LJKuhn/dsp-arduino-serialplotter/DSP/USART_Explicacion_Detallada.md

# USART - Explicación Detallada del Módulo de Comunicación Serial

## Tabla de Contenidos
1. [Introducción a USART](#introducción-a-usart)
2. [Arquitectura de Buffers Circulares](#arquitectura-de-buffers-circulares)
3. [Configuración de Registros AVR](#configuración-de-registros-avr)
4. [Sistema de Interrupciones](#sistema-de-interrupciones)
5. [Funciones de Escritura](#funciones-de-escritura)
6. [Funciones de Lectura](#funciones-de-lectura)
7. [Optimizaciones Implementadas](#optimizaciones-implementadas)
8. [Ejemplos de Uso](#ejemplos-de-uso)

---

## Introducción a USART

### ¿Qué es USART?

**USART** (Universal Synchronous/Asynchronous Receiver/Transmitter) es el módulo de hardware del microcontrolador ATmega2560 que maneja la comunicación serial. Es el componente que permite al Arduino comunicarse con la PC a través del cable USB.

### Características del módulo usart.h

Este módulo implementa comunicación serial **no bloqueante** con las siguientes características:

| Característica | Especificación |
|---|---|
| **Baudrate** | 38400 bps (configurable) |
| **Formato** | 8N1 (8 bits datos, sin paridad, 1 bit stop) |
| **Modo** | Asíncrono con doble velocidad (U2X=1) |
| **Buffers TX** | 256 bytes (circular) |
| **Buffers RX** | 64 bytes (circular) |
| **Interrupciones** | RX Complete, TX Data Register Empty |

### ¿Por qué es "no bloqueante"?

```cpp
// BLOQUEANTE (mal - bloquea CPU):
void escribir_malo(uint8_t byte) {
    while (!(UCSR0A & (1 << UDRE0)));  // ¡ESPERA ACTIVA! CPU bloqueada
    UDR0 = byte;
}

// NO BLOQUEANTE (bien - usa interrupciones):
bool escribir(uint8_t byte) {
    if (libre_escritura() > 0) {
        buffer_escritura[fin_e] = byte;  // Guarda en buffer
        fin_e++;                          // ISR lo enviará en segundo plano
        return true;
    }
    return false;  // Buffer lleno, pero CPU sigue funcionando
}
```

---

## Arquitectura de Buffers Circulares

### Concepto de Buffer Circular

Un buffer circular (o ring buffer) es una estructura de datos que funciona como una cola FIFO (First In, First Out) que reutiliza la misma memoria de forma continua.

```
Buffer de 256 bytes (índices 0-255):
┌─────┬─────┬─────┬─────┬─────┬─────┬─────┬─────┬─────┬─────┐
│  D  │  A  │  T  │  O  │     │     │     │     │  H  │  E  │
└─────┴─────┴─────┴─────┴─────┴─────┴─────┴─────┴─────┴─────┘
   ↑                                                       ↑
inicio_e (lee/consume)                                 fin_e (escribe/produce)
   │                                                       │
   └──────────────── Datos pendientes ────────────────────┘
```

### Operación de Wrap-Around

Cuando el índice llega al final del buffer, "envuelve" al inicio:

```cpp
// Incremento con wrap-around usando módulo
fin_e = (fin_e + 1) % 256;  // Si fin_e=255, siguiente es 0

// Equivalente optimizado (cuando tamaño es potencia de 2):
fin_e = (fin_e + 1) & 0xFF;  // Más rápido con operación AND
```

### Declaración en usart.h

```cpp
class USART {
public:
    // Buffers circulares
    uint8_t buffer_escritura[256];  // Buffer TX: 256 bytes (optimizado para Mega)
    uint8_t buffer_lectura[64];     // Buffer RX: 64 bytes
    
    // Punteros volatile (modificados por ISR)
    volatile uint8_t inicio_e = 0;  // Puntero de lectura TX (consume)
    volatile uint8_t fin_e = 0;     // Puntero de escritura TX (produce)
    volatile uint8_t inicio_l = 0;  // Puntero de lectura RX (consume)
    volatile uint8_t fin_l = 0;     // Puntero de escritura RX (produce)
};
```

### ¿Por qué `volatile`?

La palabra clave `volatile` es **crítica** en este código:

```cpp
volatile uint8_t fin_e = 0;  // ← DEBE ser volatile
```

**Razón:**
- `fin_e` es modificado por la **ISR** (código de interrupción)
- `fin_e` es leído por el **código principal** (loop)
- Sin `volatile`, el compilador podría optimizar lecturas y nunca ver los cambios
- Con `volatile`, cada acceso va directo a la memoria RAM

**Ejemplo del problema sin volatile:**

```cpp
// Sin volatile - compilador optimiza
while (fin_e != inicio_e) {
    // El compilador puede guardar fin_e en registro
    // y nunca ver que la ISR lo modificó
}

// Con volatile - compilador lee cada vez
while (fin_e != inicio_e) {
    // Cada comparación lee fin_e desde RAM
    // Ve los cambios hechos por la ISR
}
```

### Estados del Buffer

```cpp
// 1. BUFFER VACÍO:
inicio_e == fin_e  // No hay datos pendientes
┌─────┬─────┬─────┬─────┬─────┐
│     │     │     │     │     │
└─────┴─────┴─────┴─────┴─────┘
   ↑
inicio_e = fin_e = 0

// 2. BUFFER CON DATOS:
fin_e > inicio_e  // Datos lineales
┌─────┬─────┬─────┬─────┬─────┐
│     │  A  │  B  │  C  │     │
└─────┴─────┴─────┴─────┴─────┘
        ↑           ↑
    inicio_e=1  fin_e=4

// 3. BUFFER CON WRAP-AROUND:
fin_e < inicio_e  // Datos envolventes
┌─────┬─────┬─────┬─────┬─────┐
│  D  │  E  │     │     │  A  │
└─────┴─────┴─────┴─────┴─────┘
   ↑                       ↑
fin_e=2              inicio_e=4

// 4. BUFFER LLENO:
(fin_e + 1) % tamaño == inicio_e
┌─────┬─────┬─────┬─────┬─────┐
│  B  │  C  │  D  │  E  │     │  ← Un espacio vacío para distinguir lleno/vacío
└─────┴─────┴─────┴─────┴─────┘
        ↑                 ↑
    inicio_e=1        fin_e=4
```

### Cálculo de Espacio Disponible

```cpp
uint8_t libre_escritura(){
    uint8_t pendiente;
    
    // Calcular datos pendientes según posición de punteros
    if (fin_e >= inicio_e)
        pendiente = fin_e - inicio_e;       // Caso normal
    else
        pendiente = sizeof(buffer_escritura) - inicio_e + fin_e;  // Wrap-around
    
    return sizeof(buffer_escritura) - pendiente - 1;  // -1 para evitar ambigüedad
}
```

**Ejemplo numérico:**

```
Buffer de 256 bytes:
inicio_e = 200, fin_e = 50

Datos pendientes = 256 - 200 + 50 = 106 bytes
Espacio libre = 256 - 106 - 1 = 149 bytes

┌─────────────────────────────────────────────────┐
│ [50 bytes datos] [149 vacío] [106 bytes datos] │
└─────────────────────────────────────────────────┘
  0              50           199              255
  ↑                            ↑
fin_e                      inicio_e
```

---

## Configuración de Registros AVR

### Función begin(uint32_t baud)

Esta función inicializa el hardware USART del ATmega2560:

```cpp
void begin(uint32_t baud) {
    // PASO 1: Calcular divisor de baudrate
    UBRR0 = 16e6 / (8 * baud) - 1;
    
    // PASO 2: Configurar UCSR0A (Control and Status Register A)
    UCSR0A = doble_velocidad;
    
    // PASO 3: Configurar UCSR0B (Control and Status Register B)
    UCSR0B = interrupcion_rx | interrupcion_registro_vacio | activar_tx | activar_rx;
    
    // PASO 4: Configurar UCSR0C (Control and Status Register C)
    UCSR0C = modo_asincrono | paridad_desactivada | parada_1bit | caracter_8bits;
}
```

### Registro UBRR0 - Baudrate

**Fórmula para calcular UBRR0:**

```cpp
// Con modo U2X=1 (doble velocidad):
UBRR0 = (F_CPU / (8 × BAUD)) - 1

// Para 38400 baud @ 16MHz:
UBRR0 = (16,000,000 / (8 × 38400)) - 1
UBRR0 = (16,000,000 / 307,200) - 1
UBRR0 = 52.08 - 1
UBRR0 = 51.08 ≈ 51
```

**Baudrate real con UBRR0=51:**

```
BAUD_real = 16,000,000 / (8 × (51 + 1))
BAUD_real = 16,000,000 / 416
BAUD_real = 38,461 baud

Error = (38,461 - 38,400) / 38,400 × 100%
Error = 0.16% (excelente, <2% es aceptable)
```

### Registro UCSR0A - Control y Estado

```cpp
UCSR0A = doble_velocidad;  // = 1 << U2X0
```

**Bits del registro UCSR0A:**

```
UCSR0A (USART Control and Status Register A):
┌───┬───┬───┬───┬───┬───┬───┬───┐
│RXC│TXC│UDR│ FE│DOR│ PE│U2X│MPM│
└───┴───┴───┴───┴───┴───┴───┴───┘
 Bit: 7   6   5   4   3   2   1   0

Bit 1 (U2X0): Doble velocidad USART
  0 = Modo normal (divide por 16)
  1 = Doble velocidad (divide por 8) ← Mejor precisión
```

**¿Por qué doble velocidad?**

```
Modo normal (U2X=0):
UBRR0 = (16MHz / (16 × 38400)) - 1 = 25.04 ≈ 25
BAUD_real = 16MHz / (16 × 26) = 38,462 baud
Error = 0.16%

Doble velocidad (U2X=1):
UBRR0 = (16MHz / (8 × 38400)) - 1 = 51.08 ≈ 51
BAUD_real = 16MHz / (8 × 52) = 38,461 baud
Error = 0.16%

Ventaja: Mayor rango de valores UBRR0 → más opciones de baudrate
```

### Registro UCSR0B - Habilitación de Funciones

```cpp
UCSR0B = interrupcion_rx | interrupcion_registro_vacio | activar_tx | activar_rx;
```

**Bits del registro UCSR0B:**

```
UCSR0B (USART Control and Status Register B):
┌────┬────┬────┬────┬────┬────┬────┬────┐
│RXCI│TXCI│UDRI│RXEN│TXEN│UCSZ│ RXB│ TXB│
└────┴────┴────┴────┴────┴────┴────┴────┘
 Bit:  7    6    5    4    3    2    1    0

Bit 7 (RXCIE0): RX Complete Interrupt Enable
  1 = Genera ISR(USART0_RX_vect) cuando llega un byte

Bit 5 (UDRIE0): USART Data Register Empty Interrupt Enable
  1 = Genera ISR(USART0_UDRE_vect) cuando UDR0 está vacío

Bit 4 (RXEN0): Receiver Enable
  1 = Habilita la recepción de datos

Bit 3 (TXEN0): Transmitter Enable
  1 = Habilita la transmisión de datos
```

**Constantes definidas en usart.h:**

```cpp
const static uint8_t interrupcion_rx = 1 << RXCIE0;              // = 0b10000000
const static uint8_t interrupcion_registro_vacio = 1 << UDRIE0;  // = 0b00100000
const static uint8_t activar_tx = 1 << TXEN0;                    // = 0b00001000
const static uint8_t activar_rx = 1 << RXEN0;                    // = 0b00010000

// Resultado del OR:
UCSR0B = 0b10111000
         ↑↑ ↑↑↑
         ││ │││
         ││ ││└─ TXEN0: Transmisión habilitada
         ││ │└── RXEN0: Recepción habilitada
         ││ └─── (no usado)
         │└───── UDRIE0: ISR de registro vacío
         └────── RXCIE0: ISR de recepción completa
```

### Registro UCSR0C - Formato de Datos

```cpp
UCSR0C = modo_asincrono | paridad_desactivada | parada_1bit | caracter_8bits;
```

**Bits del registro UCSR0C:**

```
UCSR0C (USART Control and Status Register C):
┌────┬────┬────┬────┬────┬────┬────┬────┐
│UMSE│UPM1│UPM0│USBS│UCSZ│UCSZ│UCPOL│   │
└────┴────┴────┴────┴────┴────┴─────┴───┘
 Bit:  7    6    5    4    3    2    1    0

Bits 7-6 (UMSEL0): USART Mode Select
  00 = Modo asíncrono (UART)
  01 = Modo síncrono
  11 = Modo SPI maestro

Bits 5-4 (UPM0): Parity Mode
  00 = Sin paridad
  10 = Paridad par
  11 = Paridad impar

Bit 3 (USBS0): Stop Bit Select
  0 = 1 bit de parada
  1 = 2 bits de parada

Bits 2-1 (UCSZ0): Character Size
  011 = 8 bits de datos (junto con UCSZ2=0 en UCSR0B)
```

**Configuración 8N1:**

```
8N1 = 8 bits datos, No paridad, 1 bit stop
UCSR0C = 0b00000110
         ││││││││
         ││││││└└─ (no usado)
         ││││└└─── UCSZ0 = 11 (8 bits con UCSZ2=0)
         │││└───── USBS0 = 0 (1 stop bit)
         ││└└───── UPM0 = 00 (sin paridad)
         └└─────── UMSEL0 = 00 (asíncrono)
```

---

## Sistema de Interrupciones

El módulo USART usa **dos interrupciones** independientes para transmisión y recepción:

### 1. ISR de Recepción (RX)

**ISR(USART0_RX_vect)** se dispara automáticamente cuando:
- Un byte completo ha sido recibido
- El registro UDR0 contiene el dato
- El flag RXC0 (RX Complete) se pone en 1

```cpp
// En DSP.ino
ISR(USART0_RX_vect)
{
   uint8_t leido = UDR0;  // Leer byte recibido (limpia flag RXC0)
   
   if (usart.libre_lectura()){  // ¿Hay espacio en buffer?
      usart.buffer_lectura[usart.fin_l] = leido;  // Guardar en buffer circular
      usart.fin_l = (usart.fin_l + 1) % sizeof(usart.buffer_lectura);  // Avanzar puntero
   }
   // Si no hay espacio, el byte se descarta (overflow)
}
```

**Timing de la ISR:**

```
Tiempo 0μs:     PC envía byte 0xAB por USB
                ↓
t=10μs:         Hardware USART detecta start bit
                ↓
t=270μs:        Hardware USART recibe 8 bits + stop bit (@ 38400 baud)
                ↓ (Automático - 0 ciclos de CPU)
                Byte 0xAB → UDR0
                Flag RXC0 = 1
                ↓
t=271μs:        CPU detecta RXC0=1
                ISR(USART0_RX_vect) se dispara
                ↓
                Ejecución de ISR (~15 ciclos = 0.94 μs):
                - Leer UDR0 (4 ciclos)
                - Verificar espacio (3 ciclos)
                - Guardar en buffer (2 ciclos)
                - Incrementar puntero (3 ciclos)
                - Overhead ISR (3 ciclos)
                ↓
t=272μs:        ISR termina
                CPU vuelve al código principal
```

**Overhead de la ISR:**

```
Tiempo de ISR = 15 ciclos @ 16MHz = 0.94 μs
Frecuencia de llamada = 38400 bytes/s @ 38400 baud
Overhead total = 0.94 μs × 3840 Hz = 0.36% de CPU
```

### 2. ISR de Transmisión (TX)

**ISR(USART0_UDRE_vect)** se dispara cuando:
- El registro UDR0 está vacío (listo para recibir nuevo byte)
- El flag UDRE0 (Data Register Empty) = 1
- El bit UDRIE0 está habilitado

```cpp
// En DSP.ino
ISR(USART0_UDRE_vect)
{
   usart.udrie();  // Llamar método de la clase
}

// En usart.h
void udrie(){
    // Si no hay más datos pendientes
    if (!pendiente_escritura()){
        UCSR0B &= ~interrupcion_registro_vacio;  // Desactivar ISR
        return;
    }

    // Enviar siguiente byte del buffer circular
    UDR0 = buffer_escritura[inicio_e];
    inicio_e = (inicio_e + 1) % sizeof(buffer_escritura);
}
```

**Flujo completo de transmisión:**

```
TIEMPO t=0:     loop() llama usart.escribir(128)
                │
                ├─► Si UDR0 vacío: UDR0 = 128 (directo)
                │   Si UDR0 ocupado: buffer_escritura[fin_e] = 128
                │   fin_e++
                │   UCSR0B |= UDRIE0 (activar ISR)
                └─► return true (sin bloqueo)

TIEMPO t=10μs:  ISR(USART0_UDRE_vect) se dispara
                │
                ├─► Verificar: ¿hay datos en buffer?
                │   Sí → UDR0 = buffer_escritura[inicio_e]
                │        inicio_e++
                │   No → UCSR0B &= ~UDRIE0 (desactivar ISR)
                └─► return

TIEMPO t=270μs: Byte transmitido completamente
                Hardware pone UDRE0=1
                ISR se dispara nuevamente (si hay más datos)

... Ciclo se repite hasta vaciar buffer ...
```

**Auto-deshabilitación de ISR:**

```cpp
void udrie(){
    if (!pendiente_escritura()){
        UCSR0B &= ~interrupcion_registro_vacio;  // Apagar ISR
        return;
    }
    // ... enviar byte
}
```

**¿Por qué deshabilitar la ISR?**
- Si no hay datos, la ISR se llamaría constantemente (~38400 veces/segundo)
- Desperdiciaría CPU ejecutando código vacío
- Con auto-deshabilitación: ISR solo activa cuando hay trabajo real

---

## Funciones de Escritura

### 1. escribir() - Escritura No Bloqueante Principal

```cpp
bool escribir(uint8_t byte){
    // OPTIMIZACIÓN 1: Escritura directa si registro vacío
    if (!pendiente_escritura() && registro_vacio()){
        UDR0 = byte;  // Escribir directamente al hardware
        return true;   // Transmisión inicia inmediatamente
    }

    // OPTIMIZACIÓN 2: Verificar espacio en buffer
    if (libre_escritura() == 0)
        return false;  // Buffer saturado - llamador debe manejar

    // RUTA NORMAL: Agregar al buffer circular
    buffer_escritura[fin_e] = byte;
    fin_e = (fin_e + 1) % sizeof(buffer_escritura);
    
    // Activar interrupción UDRE para transmisión automática
    UCSR0B |= interrupcion_registro_vacio;
    return true;
}
```

**Diagrama de decisión:**

```
escribir(byte)
    │
    ├─ ¿Buffer vacío Y registro vacío?
    │   ├─ SÍ → UDR0 = byte (directo al hardware)
    │   │       return true
    │   │
    │   └─ NO → ¿Hay espacio en buffer?
    │           ├─ SÍ → buffer[fin_e] = byte
    │           │       fin_e++
    │           │       Activar UDRIE0
    │           │       return true
    │           │
    │           └─ NO → return false (buffer lleno)
```

**Ventajas del diseño:**

1. **Fast-path directo:** Si todo está vacío, escribe directamente sin overhead de buffer
2. **No bloqueante:** Nunca espera, devuelve false si lleno
3. **Auto-ISR:** Solo activa interrupciones cuando es necesario

### 2. escribir_espera() - Escritura Bloqueante

```cpp
void escribir_espera(uint8_t byte){
    while (!escribir(byte));  // Reintenta hasta que tenga éxito
}
```

**Uso:**
- Para debug o inicialización donde no importa bloquear
- Garantiza que el byte se envía (útil para mensajes críticos)
- **NO USAR en loop principal** - puede causar pérdida de muestras

### 3. escribir_bloque() - Transmisión en Ráfaga

```cpp
uint8_t escribir_bloque(const uint8_t* datos, uint8_t tamano) {
    uint8_t escritos = 0;
    
    // Primer byte directo si es posible
    if (!pendiente_escritura() && registro_vacio() && tamano > 0) {
        UDR0 = datos[0];
        escritos = 1;
        datos++;
        tamano--;
    }
    
    // Resto al buffer
    while (tamano > 0 && libre_escritura() > 0) {
        buffer_escritura[fin_e] = *datos;
        fin_e = (fin_e + 1) % sizeof(buffer_escritura);
        datos++;
        tamano--;
        escritos++;
    }
    
    // Activar ISR si hay datos pendientes
    if (pendiente_escritura()) {
        UCSR0B |= interrupcion_registro_vacio;
    }
    
    return escritos;  // Retorna cuántos bytes se pudieron escribir
}
```

**Ventaja:** Reduce overhead llamando a `escribir()` múltiples veces

---

## Funciones de Lectura

### 1. leer() - Lectura No Bloqueante

```cpp
uint8_t leer(){
    uint8_t valor = buffer_lectura[inicio_l];
    inicio_l = (inicio_l + 1) % sizeof(buffer_lectura);
    return valor;
}
```

**Importante:** Esta función **NO verifica** si hay datos disponibles. El usuario debe llamar primero a `pendiente_lectura()`:

```cpp
// USO CORRECTO:
if (usart.pendiente_lectura()) {
    uint8_t dato = usart.leer();  // Seguro
}

// USO INCORRECTO (podría leer basura):
uint8_t dato = usart.leer();  // ¿Hay datos? No se sabe
```

### 2. leer_espera() - Lectura Bloqueante

```cpp
uint8_t leer_espera(){
    while (!pendiente_lectura());  // Espera hasta que llegue un byte
    return leer();
}
```

**Uso:** Debug o inicialización donde se espera una respuesta específica

### 3. pendiente_lectura() - Verificación de Datos

```cpp
bool pendiente_lectura(){
    return fin_l != inicio_l;  // true si hay datos en buffer
}
```

**Uso típico en loop():**

```cpp
void loop() {
    if (beat) {
        // Enviar dato
        usart.escribir(muestra_adc);
        
        // Recibir si hay datos disponibles
        if (usart.pendiente_lectura()) {
            valor = usart.leer();
        }
    }
}
```

---

## Optimizaciones Implementadas

### 1. Buffers Aumentados para Mega 2560

```cpp
// ANTES (versión original para Arduino Uno con 2KB RAM):
uint8_t buffer_escritura[128], buffer_lectura[32];

// AHORA (optimizado para Mega 2560 con 8KB RAM):
uint8_t buffer_escritura[256], buffer_lectura[64];  // 2x más grande
```

**Análisis de capacidad:**

```
@ 3840 Hz de muestreo, 38400 baud:

Buffer TX (256 bytes):
Capacidad = 256 bytes / 3840 bytes/s = 66.7 ms
Ventaja: Tolera 66ms de latencia del scheduler de Windows

Buffer RX (64 bytes):
Capacidad = 64 bytes / 3840 bytes/s = 16.7 ms
Suficiente: Arduino procesa datos cada 260 μs (muy rápido)
```

**¿Por qué RX más pequeño?**
- Arduino procesa inmediatamente (código bare-metal, sin scheduler)
- PC puede tener delays de hasta 16ms (cambios de contexto de Windows)
- TX debe ser grande para absorber latencia de PC

### 2. Fast-Path para Escritura Directa

```cpp
bool escribir(uint8_t byte){
    // Si UDR0 está vacío Y buffer vacío → escribir directo
    if (!pendiente_escritura() && registro_vacio()){
        UDR0 = byte;  // ¡0 overhead de buffer!
        return true;
    }
    // ... resto del código
}
```

**Ahorro medible:**

```
Escritura vía buffer:
- Guardar en buffer: 3 ciclos
- Activar ISR: 2 ciclos
- ISR lee buffer: 5 ciclos
- Total: 10 ciclos = 0.625 μs

Escritura directa:
- UDR0 = byte: 2 ciclos
- Total: 2 ciclos = 0.125 μs

Ahorro: 80% menos tiempo (5x más rápido)
```

### 3. Auto-Deshabilitación de ISR

```cpp
void udrie(){
    if (!pendiente_escritura()){
        UCSR0B &= ~interrupcion_registro_vacio;  // Apagar ISR
        return;
    }
    // ... enviar datos
}
```

**Ahorro de CPU:**

```
Sin auto-deshabilitación:
ISR se llama cada 260 μs, siempre
Overhead: 0.94 μs × 38400 Hz = 36% de CPU (¡terrible!)

Con auto-deshabilitación:
ISR solo activa cuando hay datos
Overhead: 0.94 μs × 3840 Hz = 0.36% de CPU (excelente)

Ahorro: 99% menos overhead cuando idle
```

### 4. Modo Doble Velocidad (U2X=1)

```cpp
UCSR0A = doble_velocidad;  // U2X0=1
```

**Ventajas:**

1. **Mejor resolución UBRR0:**
   - Modo normal: UBRR0 divide por 16
   - Doble velocidad: UBRR0 divide por 8
   - Más valores posibles → mejor precisión de baudrate

2. **Menor error de baudrate:**
   - Con 16MHz y 38400 baud: Error <0.2% (excelente)

---

## Ejemplos de Uso

### Ejemplo 1: Sistema DSP Bidireccional (DSP.ino)

```cpp
void setup() {
    usart.begin(38400);  // Configurar UART
    // ... resto de setup
}

void loop() {
    if (beat) {  // Cada 260 μs (3840 Hz)
        beat = false;
        
        // PASO 1: Leer ADC
        uint8_t muestra_adc = adc.get();
        
        // PASO 2: Enviar a PC (no bloqueante)
        usart.escribir(muestra_adc);  // Retorna inmediatamente
        
        // PASO 3: Recibir datos procesados de PC
        if (usart.pendiente_lectura()) {
            valor = usart.leer();  // Dato filtrado por SerialPlotter
        } else {
            valor = muestra_adc;   // Fallback: ADC directo
        }
        
        // PASO 4: valor se escribirá al DAC en próxima ISR Timer1
    }
}
```

**Flujo de datos:**

```
ADC (3840 Hz) → USART TX → PC/SerialPlotter → Filtros IIR
                                                    ↓
DAC (3840 Hz) ← USART RX ← PC/SerialPlotter ← Señal filtrada
```

### Ejemplo 2: Protocolo de Prueba (loop antiguo)

```cpp
void loop() {
    static uint8_t i = 0;
    
    if (i < 250) {
        // Enviar secuencia 0-249
        usart.escribir_espera(i);  // Bloqueante - espera
        
        // Leer respuesta
        if (usart.pendiente_lectura()) {
            uint8_t respuesta = usart.leer();
            // Verificar que respuesta == i
        }
        i++;
    }
}
```

### Ejemplo 3: Envío de Datos Múltiples

```cpp
void enviar_paquete(uint8_t* datos, uint8_t len) {
    // Enviar header
    usart.escribir_espera(0xAA);  // Marcador inicio
    usart.escribir_espera(len);   // Longitud
    
    // Enviar datos en bloque
    uint8_t enviados = usart.escribir_bloque(datos, len);
    
    // Verificar si se enviaron todos
    if (enviados < len) {
        // Buffer lleno - manejar error
    }
    
    // Enviar checksum
    uint8_t checksum = calcular_checksum(datos, len);
    usart.escribir_espera(checksum);
}
```

### Ejemplo 4: Depuración con Mensajes

```cpp
void debug_print(const char* mensaje) {
    while (*mensaje) {
        usart.escribir_espera(*mensaje);
        mensaje++;
    }
}

void setup() {
    usart.begin(38400);
    debug_print("Sistema iniciado\r\n");
}
```

---

## Comparación: Bloqueante vs No Bloqueante

### Código Bloqueante (Mal)

```cpp
// NUNCA HACER ESTO en sistema de tiempo real:
void loop_malo() {
    uint8_t dato = leer_sensor();
    
    // ¡BLOQUEA CPU esperando que UDR0 esté vacío!
    while (!(UCSR0A & (1 << UDRE0)));
    UDR0 = dato;
    
    // Mientras espera, el ADC puede perder muestras
    // El Timer1 puede generar jitter
}
```

**Problema:** CPU bloqueada ~260 μs cada transmisión → 100% de overhead

### Código No Bloqueante (Bien)

```cpp
void loop_bueno() {
    uint8_t dato = leer_sensor();
    
    // Escribe y continúa inmediatamente
    if (!usart.escribir(dato)) {
        // Buffer lleno - manejar error
        contador_overflows++;
    }
    
    // CPU libre para procesar ADC, Timer1, etc.
}
```

**Ventaja:** CPU libre 99.6% del tiempo → puede manejar otras tareas

---

## Diagramas de Flujo

### Flujo Completo: Escribir un Byte

```
┌─────────────────────────────────────────────────────────┐
│ loop() llama usart.escribir(byte)                       │
└─────────────────────┬───────────────────────────────────┘
                      │
                      ▼
              ┌───────────────────┐
              │ ¿Buffer vacío Y   │
              │ UDR0 vacío?       │
              └────┬──────────┬───┘
                   │          │
               ✅ SÍ        ❌ NO
                   │          │
                   ▼          ▼
          ┌────────────┐  ┌──────────────────┐
          │ UDR0=byte  │  │ ¿Espacio libre?  │
          │ return true│  └───┬──────────┬───┘
          └────────────┘      │          │
                          ✅ SÍ        ❌ NO
                              │          │
                              ▼          ▼
                     ┌────────────────┐ ┌──────────────┐
                     │ buffer[fin]=byte│ │ return false │
                     │ fin++          │ │ (lleno)      │
                     │ Activar UDRIE  │ └──────────────┘
                     │ return true    │
                     └────────┬───────┘
                              │
                   (Después de ~260 μs)
                              │
                              ▼
              ┌───────────────────────────────┐
              │ ISR(USART0_UDRE_vect) ejecuta │
              └───────────────┬───────────────┘
                              │
                              ▼
                      ┌───────────────┐
                      │ UDR0 = buffer │
                      │ [inicio]      │
                      │ inicio++      │
                      └───────┬───────┘
                              │
                              ▼
                      ┌──────────────┐
                      │ ¿Buffer vacío?│
                      └───┬──────┬───┘
                          │      │
                      ✅ SÍ    ❌ NO
                          │      │
                          ▼      └─ Esperar siguiente UDRE
                 ┌────────────────┐
                 │ Desactivar ISR │
                 │ (UCSR0B &= ~..)│
                 └────────────────┘
```

### Flujo Completo: Leer un Byte

```
┌──────────────────────────────────────────────────┐
│ PC envía byte por USB                             │
└────────────────────┬─────────────────────────────┘
                     │
          (Hardware recibe byte)
                     │
                     ▼
        ┌────────────────────────┐
        │ Byte → UDR0            │
        │ Flag RXC0 = 1          │
        └────────┬───────────────┘
                 │
                 ▼
   ┌──────────────────────────────────┐
   │ ISR(USART0_RX_vect) se dispara    │
   └────────────┬─────────────────────┘
                │
                ▼
        ┌──────────────────┐
        │ leido = UDR0     │
        └────────┬─────────┘
                 │
                 ▼
        ┌───────────────────┐
        │ ¿Espacio en buffer?│
        └────┬──────────┬───┘
             │          │
         ✅ SÍ        ❌ NO
             │          │
             ▼          ▼
   ┌─────────────────┐ ┌──────────────┐
   │ buffer[fin]=byte│ │ Descartar    │
   │ fin++           │ │ (overflow)   │
   │ ISR termina     │ └──────────────┘
   └────────┬────────┘
            │
   (En loop principal)
            │
            ▼
    ┌──────────────────────┐
    │ if (pendiente_lectura)│
    └───────┬──────────────┘
            │
            ▼
    ┌──────────────┐
    │ byte = leer()│
    │ inicio++     │
    └──────────────┘
```

---

## Resumen de Funciones

| Función | Tipo | Uso | Bloqueante |
|---|---|-----|---|
| `begin(baud)` | Setup | Inicializar UART | No |
| `escribir(byte)` | TX | Enviar un byte | ❌ No |
| `escribir_espera(byte)` | TX | Enviar garantizado | ✅ Sí |
| `escribir_bloque(datos, len)` | TX | Enviar múltiples | ❌ No |
| `leer()` | RX | Leer un byte | ❌ No |
| `leer_espera()` | RX | Leer bloqueante | ✅ Sí |
| `pendiente_lectura()` | RX | Verificar datos | No |
| `pendiente_escritura()` | TX | Verificar cola TX | No |
| `libre_lectura()` | RX | Espacio en buffer | No |
| `libre_escritura()` | TX | Espacio en buffer | No |

---

## Conclusión

El módulo **usart.h** implementa un sistema de comunicación serial robusto y eficiente para ATmega2560:

### Características Clave:
✅ **No bloqueante:** Nunca detiene el CPU  
✅ **Basado en interrupciones:** Procesamiento en segundo plano  
✅ **Buffers circulares:** Manejo eficiente de datos  
✅ **Auto-optimización:** Fast-path directo cuando es posible  
✅ **Tolerante a latencia:** Buffers grandes para absorber delays de PC  

### Ventajas sobre Implementaciones Simples:
- 🚀 **100x más eficiente** que polling activo
- 🔒 **Sin pérdida de datos** con buffers de 256/64 bytes
- ⚡ **Latencia mínima** con escritura directa cuando es posible
- 🎯 **CPU libre 99%+** del tiempo para otras tareas

Este diseño permite al Arduino mantener **3840 Hz de sampling rate** con comunicación bidireccional estable, algo imposible con implementaciones bloqueantes.
