LJKuhn/dsp-arduino-serialplotter/SerialPlotter/src/MainWindow.cpp

// MainWindow.cpp - Ventana principal del visualizador de señales
//
// Arquitectura:
// - Panel lateral izquierdo (240px): Controles de puerto, configuración y conexión
// - Área de gráficos derecha: 3 gráficos apilados verticalmente
//   1. Entrada: señal cruda recibida por serial
//   2. Salida: señal filtrada (pasa bajos, pasa altos o ninguno)
//   3. Espectro: análisis FFT de la señal
//
// Modo Congelar:
// - Permite "pausar" la visualización sin detener la adquisición de datos
// - Guarda un snapshot (copia completa) de los datos actuales en frozen_dataX/Y/Y_filtered
// - Permite hacer zoom independiente del modo en vivo
// - La adquisición continúa en segundo plano y se puede reanudar sin pérdida
//
// Thread-safety:
// - SerialWorker (serial_thread): lee datos del puerto serial y actualiza scrollX, scrollY y filter_scrollY
//   * Protegido por data_mutex para evitar condiciones de carrera durante freeze/unfreeze
// - AnalysisWorker (analysis_thread): calcula FFT periódicamente cuando está en modo en vivo
//   * Pausado automáticamente en modo congelado para no procesar datos nuevos
// - Draw (UI thread): visualiza datos congelados (snapshot) o en vivo (buffers circulares)
//   * Lee buffers de forma thread-safe usando data_mutex solo durante la copia del snapshot

#include <imgui.h>
#include <imgui_internal.h>

#include <implot.h>
#include <Iir.h>
#include <thread>
#include <algorithm>  // Para std::min

#include "MainWindow.h"

#include "Buffers.h"
#include "Settings.h"

// Velocidades de comunicación serial estándar (bits por segundo)
// Arduino Mega 2560 soporta baudrates más altos que Uno
const int bauds[] = { 1200, 2400, 4800, 9600, 14400, 19200, 38400, 57600, 115200, 230400, 250000, 460800, 500000, 921600, 1000000, 2000000 };

// Frecuencias de muestreo disponibles (Hz) - optimizadas para Arduino Mega
// El Mega puede manejar frecuencias más altas gracias a sus 4 UARTs y más RAM
const int frecuencias[] = { 120, 240, 480, 960, 1440, 1920, 3840, 5760, 7680, 11520, 15360, 23040, 25000, 46080, 50000, 92160, 100000 };

#include "Widgets.h"

using namespace std::chrono_literals;

Iir::Butterworth::LowPass<8> lowpass_filter;
Iir::Butterworth::HighPass<8> highpass_filter;

// Declaraciones de funciones de Settings.cpp
void ComboFrecuenciaMuestreo(int& selected);
void ComboBaudRate(int& selected);
void ComboPuertos(std::string& selected_port);

void MenuPuertos(std::string& selected_port) {
    std::function to_string = [](std::string s) { return s; };

    select_menu("Puerto", selected_port, std::function(EnumerateComPorts), to_string,
                "No hay ningún dispositivo conectado");
}

bool Button(const char* label, bool disabled = false) {
    if (disabled) {
        // Simular botón deshabilitado (ImGui no tiene disable nativo en versiones antiguas)
        ImGui::PushItemFlag(ImGuiItemFlags_Disabled, true);
        ImGui::PushStyleVar(ImGuiStyleVar_Alpha, ImGui::GetStyle().Alpha * 0.5f);

        ImGui::Button(label);

        ImGui::PopStyleVar();
        ImGui::PopItemFlag();
        return false;
    }
    return ImGui::Button(label);
}

bool Button(const char* label, ImVec2 size, bool disabled = false) {
    if (disabled) {
        // Simular botón deshabilitado con transparencia reducida
        ImGui::PushItemFlag(ImGuiItemFlags_Disabled, true);
        ImGui::PushStyleVar(ImGuiStyleVar_Alpha, ImGui::GetStyle().Alpha * 0.5f);

        ImGui::Button(label, size);

        ImGui::PopStyleVar();
        ImGui::PopItemFlag();
        return false;
    }
    return ImGui::Button(label, size);
}

std::string MetricFormatter(double value, std::string_view unit) {
    static double v[] = { 1e12, 1e9, 1e6, 1e3, 1, 1e-3, 1e-6, 1e-9, 1e-12 };
    static const char* p[] = { "T", "G", "M", "k", "", "m", "u", "n", "p" };

    if (value == 0) {
        return "";
    }

    // Seleccionar el prefijo métrico apropiado (T, G, M, k, m, u, n, p)
    for (int i = 0; i < std::size(p); ++i) {
        if (fabs(value) >= v[i]) {
            return std::format("{:g} {}{}", value / v[i], p[i], unit);
        }
    }
    return "";
}

int MetricFormatter(double value, char* buff, int size, void* data) {
    const char* unit = (const char*)data;
    static double v[] = { 1e12, 1e9, 1e6, 1e3, 1, 1e-3, 1e-6, 1e-9, 1e-12 };
    static const char* p[] = { "T", "G", "M", "k", "", "m", "u", "n", "p" };

    if (value == 0) {
        return snprintf(buff, size, "0 %s", unit);
    }

    // Seleccionar el prefijo métrico apropiado (T, G, M, k, m, u, n, p)
    for (int i = 0; i < std::size(p); ++i) {
        if (fabs(value) >= v[i]) {
            return snprintf(buff, size, "%g %s%s", value / v[i], p[i], unit);
        }
    }
    return snprintf(buff, size, "%g %s%s", value / v[std::size(v) - 1], p[std::size(p) - 1], unit);
}


MainWindow::MainWindow(int width, int height, Settings& config, SettingsWindow& ventanaConfig) :
    settings(&config), settingsWindow(&ventanaConfig), width(width), height(height)
{
    CreateBuffers();
}

MainWindow::~MainWindow()
{
    Stop();
    DestroyBuffers();
}

void MainWindow::CreateBuffers() {
    int speed = settings->sampling_rate;
    int max_size = speed * max_time;  // Buffer para max_time segundos de datos
    int view_size = 30 * speed;  // Vista inicial de 30 segundos

    // IMPORTANTE: Destruir buffers existentes primero (con protección mutex)
    DestroyBuffers();
    
    // CRÍTICO: Adquirir mutex para crear buffers de forma atómica
    std::lock_guard<std::mutex> lock(data_mutex);
    
    // Resetear estado
    size = 0;
    next_time = 0.0;
    
    // Aumentar tamaño de buffers para reducir overhead de lecturas pequeñas
    // Arduino Mega tiene más RAM, podemos usar buffers más grandes
    read_buffer.resize(512);   // Era 128, ahora 512 (4x más)
    write_buffer.resize(512);  // Era 128, ahora 512 (4x más)

    // Crear buffers circulares para datos en tiempo real
    fft = new FFT(settings->sampling_rate);
    scrollX = new ScrollBuffer<double>(max_size, view_size);
    scrollY = new ScrollBuffer<double>(max_size, view_size);
    filter_scrollY = new ScrollBuffer<double>(max_size, view_size);
}

void MainWindow::DestroyBuffers() {
    // CRÍTICO: Adquirir mutex para evitar que Draw() acceda a buffers mientras se destruyen
    std::lock_guard<std::mutex> lock(data_mutex);
    
    // Eliminar buffers y asegurar que los punteros sean nullptr
    if (scrollX) {
        delete scrollX;
        scrollX = nullptr;
    }
    if (scrollY) {
        delete scrollY;
        scrollY = nullptr;
    }
    if (filter_scrollY) {
        delete filter_scrollY;
        filter_scrollY = nullptr;
    }
    if (fft) {
        delete fft;
        fft = nullptr;
    }
    
    // Resetear contadores
    size = 0;
    next_time = 0.0;
}

double MainWindow::TransformSample(uint8_t v) {
    return (v - settings->minimum) * settings->map_factor - 6;
}

uint8_t MainWindow::InverseTransformSample(double v) {
    double result = round((v + 6) * (settings->maximum - settings->minimum) / 12.0 + settings->minimum);
    if (result < 0)
        return 0;
    if (result > 255)
        return 255;
    return (int)result;
}


void MainWindow::ToggleConnection()
{
    if (!started) {
        if (settings->port.empty())
            return;

        Start();
    }
    else {
        Stop();
    }
    started = !started;
}

void MainWindow::ToggleFreeze()
{
    frozen = !frozen;
    
    if (frozen) {
        // Guardar límites de zoom actuales para modo congelado independiente
        frozen_left_limit = left_limit;
        frozen_right_limit = right_limit;
        frozen_down_limit = down_limit;
        frozen_up_limit = up_limit;
        
        // Copiar snapshot de datos actuales de forma thread-safe
        // El mutex protege contra escrituras del SerialWorker mientras copiamos
        std::lock_guard<std::mutex> lock(data_mutex);
        
        if (scrollX && scrollY && filter_scrollY) {
            frozen_size = scrollX->count();
            
            if (frozen_size > 0) {
                frozen_dataX.resize(frozen_size);
                frozen_dataY.resize(frozen_size);
                frozen_dataY_filtered.resize(frozen_size);
                
                // Copiar elemento por elemento (el operador [] maneja el offset del buffer circular)
                for (int i = 0; i < frozen_size; i++) {
                    frozen_dataX[i] = (*scrollX)[i];
                    frozen_dataY[i] = (*scrollY)[i];
                    frozen_dataY_filtered[i] = (*filter_scrollY)[i];
                }
            }
        }
    }
    else {
        // Liberar memoria del snapshot al reanudar modo en vivo
        frozen_dataX.clear();
        frozen_dataY.clear();
        frozen_dataY_filtered.clear();
    }
}

void MainWindow::DrawSidebar()
{
    static int stride_exp = 2;  // Exponente para calcular stride (2^n)
    
    // Escalas de tiempo POR DIVISIÓN (en segundos)
    // Estas representan el tiempo que hay ENTRE cada división vertical
    static const float time_per_division[] = { 
        0.001f, 0.002f, 0.005f, 0.01f, 0.02f, 0.05f, 0.1f, 0.2f, 0.5f, 
        1.0f, 1.5f, 2.0f 
    };
    static const char* time_scale_labels[] = { 
        "1 ms/div", "2 ms/div", "5 ms/div", "10 ms/div", "20 ms/div", "50 ms/div", 
        "100 ms/div", "200 ms/div", "500 ms/div",
        "1 s/div", "1.5 s/div", "2 s/div"
    };
    static const int num_time_scales = std::size(time_per_division);
    
    // Panel lateral izquierdo: ocupa toda la altura de la ventana
    ImGui::SetNextWindowPos({ 0, 0 });
    ImGui::SetNextWindowSize(ImVec2(sidebar_width, height));
    ImGui::PushStyleVar(ImGuiStyleVar_WindowBorderSize, 0);
    ImGui::PushStyleVar(ImGuiStyleVar_WindowPadding, ImVec2(10, 10));
    
    ImGui::Begin("Panel de Control", nullptr,
                 ImGuiWindowFlags_NoResize | ImGuiWindowFlags_NoTitleBar | 
                 ImGuiWindowFlags_NoCollapse | ImGuiWindowFlags_NoMove);
    
    ImGui::PopStyleVar(2);

    // Título principal
    ImGui::TextColored(ImVec4(0.110f, 0.784f, 0.035f, 1.0f), "CONTROL");
    ImGui::Separator();
    ImGui::Spacing();

    // === SECCIÓN PUERTO ===
    ImGui::PushStyleColor(ImGuiCol_Text, ImVec4(0.110f, 0.784f, 0.035f, 1.0f));
    ImGui::Text("PUERTO");
    ImGui::PopStyleColor();
    ImGui::Separator();
    ImGui::Spacing();
    ComboPuertos(settings->port);
    ImGui::Spacing();

    // === SECCIÓN CONFIGURACIÓN ===
    ImGui::PushStyleColor(ImGuiCol_Text, ImVec4(0.110f, 0.784f, 0.035f, 1.0f));
    ImGui::Text("CONFIGURACION");
    ImGui::PopStyleColor();
    ImGui::Separator();
    ImGui::Spacing();
    
    // Frecuencia de muestreo (actualiza samples y baud_rate automáticamente)
    int old_sampling = settings->sampling_rate;
    ComboFrecuenciaMuestreo(settings->sampling_rate);
    if (old_sampling != settings->sampling_rate) {
        settings->samples = settings->sampling_rate;
        settings->baud_rate = settings->sampling_rate * 10;  // Relación 10:1 para transmisión estable
    }
    
    ComboBaudRate(settings->baud_rate);
    
    ImGui::Spacing();

    // Mapeo de valores ADC (0-255) a voltaje (-6V a +6V)
    if (ImGui::SliderInt("Maximo", &settings->maximum, 0, 255)) {
        settings->map_factor = 12.0 / (settings->maximum - settings->minimum);
    }
    if (ImGui::IsItemHovered()) {
        ImGui::SetTooltip("Valor ADC que corresponde a +6V\n"
                         "Calibracion: ajusta segun el rango real de tu hardware\n"
                         "Por defecto: 255 (rango completo ADC)");
    }
    
    if (ImGui::SliderInt("Minimo", &settings->minimum, 0, 255)) {
        settings->map_factor = 12.0 / (settings->maximum - settings->minimum);
    }
    if (ImGui::IsItemHovered()) {
        ImGui::SetTooltip("Valor ADC que corresponde a -6V\n"
                         "Calibracion: ajusta segun el rango real de tu hardware\n"
                         "Por defecto: 0 (rango completo ADC)");
    }
    
    // Selector de tiempo por división (como en un osciloscopio real)
    ImGui::Text("Tiempo/Division");
    if (ImGui::BeginCombo("##TimeScale", time_scale_labels[time_scale_index])) {
        for (int i = 0; i < num_time_scales; i++) {
            const bool is_selected = (time_scale_index == i);
            if (ImGui::Selectable(time_scale_labels[i], is_selected)) {
                time_scale_index = i;
                // Calcular el tiempo total visible: 16 divisiones × tiempo por división
                max_time_visible = time_per_division[i] * 16;
                
                // NO hacer nada más aquí - el ajuste de límites se hace automáticamente en Draw()
                // Esto asegura que right_limit = left_limit + max_time_visible siempre
            }
            if (is_selected)
                ImGui::SetItemDefaultFocus();
        }
        ImGui::EndCombo();
    }
    if (ImGui::IsItemHovered()) {
        ImGui::SetTooltip("Tiempo por division (16 divisiones totales)\nLas divisiones siempre ocupan todo el ancho del grafico");
    }
    
    // Stride: dibuja 1 de cada 2^n muestras para mejorar rendimiento
    if (ImGui::SliderInt("Stride", &stride_exp, 0, 10)) {
        settings->stride = (int)exp2(stride_exp);
        settings->byte_stride = sizeof(double) * settings->stride;
    }
    if (ImGui::IsItemHovered()) {
        ImGui::SetTooltip("Optimizacion de rendimiento:\nStride = %d -> Dibuja 1 de cada %d muestras\n\nMayor = Mejor FPS, Menor detalle", 
                         settings->stride, settings->stride);
    }
    
    ImGui::Checkbox("Mostrar FPS", &settings->show_frame_time);
    ImGui::Spacing();

    // === SECCIÓN CONEXIÓN ===
    ImGui::PushStyleColor(ImGuiCol_Text, ImVec4(0.110f, 0.784f, 0.035f, 1.0f));
    ImGui::Text("CONEXION");
    ImGui::PopStyleColor();
    ImGui::Separator();
    ImGui::Spacing();
    
    // Botón Conectar/Desconectar (deshabilitado si no hay puerto seleccionado)
    if (Button(started ? "Desconectar" : "Conectar", ImVec2(-1, 0), settings->port.empty())) {
        ToggleConnection();
    }
    if (settings->port.empty()) {
        ImGui::SetItemTooltip("Selecciona un dispositivo primero");
    }
    ImGui::Spacing();

    // Botón Congelar/Reanudar (solo visible cuando hay conexión activa)
    if (started) {
        if (frozen) {
            // Botón verde brillante cuando está en modo congelado
            ImGui::PushStyleColor(ImGuiCol_Button, ImVec4(0.15f, 0.9f, 0.05f, 1.0f));
            if (ImGui::Button("Reanudar", ImVec2(-1, 0))) {
                ToggleFreeze();
            }
            ImGui::PopStyleColor();
        }
        else {
            if (ImGui::Button("Congelar", ImVec2(-1, 0))) {
                ToggleFreeze();
            }
        }
        ImGui::SetItemTooltip("Congela la visualización para analizar sin detener la adquisición");
    }

    // === SECCIÓN INFORMACIÓN (siempre en la parte inferior del sidebar) ===
    float info_start_y = ImGui::GetWindowHeight() - 80;
    if (ImGui::GetCursorPosY() < info_start_y) {
        ImGui::SetCursorPosY(info_start_y);
    }
    
    ImGui::Separator();
    ImGui::Spacing();
    
    ImGui::PushStyleColor(ImGuiCol_Text, ImVec4(0.110f, 0.784f, 0.035f, 1.0f));
    ImGui::Text("INFORMACION");
    ImGui::PopStyleColor();
    ImGui::Separator();
    ImGui::Spacing();
    
    // Tiempo transcurrido (del snapshot congelado o de datos en vivo)
    double elapsed = 0.0;
    if (started) {
        if (frozen && !frozen_dataX.empty()) {
            elapsed = frozen_dataX.back();
        }
        else if (!frozen) {
            // VALIDACIÓN CRÍTICA: Proteger acceso a scrollX
            std::lock_guard<std::mutex> lock(data_mutex);
            if (scrollX && scrollX->count() > 0) {
                elapsed = scrollX->back();
            }
        }
    }
    ImGui::Text("Tiempo: %.1fs", elapsed);
    
    // Indicador visual de estado congelado
    if (frozen) {
        ImGui::TextColored(ImVec4(0.110f, 0.784f, 0.035f, 1.0f), "[CONGELADO]");
    }
    
    // FPS (si está habilitado en configuración)
    if (settings->show_frame_time) {
        ImGuiIO& io = ImGui::GetIO();
        ImGui::Text("FPS: %.1f", io.Framerate);
    }

    ImGui::End();
}

void MainWindow::Start() {
    CreateBuffers();

    // Inicializar límites con la escala temporal actual
    left_limit = 0;
    right_limit = max_time_visible;

    // Configurar parámetros de filtros según frecuencia de muestreo
    SetupFilter();
    ResetFilters();

    // Iniciar hilos de trabajo en paralelo
    do_serial_work = true;
    do_analysis_work = true;
    analysis_thread = std::thread(&MainWindow::AnalysisWorker, this);

    // Abrir puerto serial y comenzar adquisición
    serial.open(settings->port, settings->baud_rate);
    serial_thread = std::thread(&MainWindow::SerialWorker, this);
    start_time = clock::now();
}

void MainWindow::Stop() {
    // Señalizar a los hilos que deben terminar
    do_serial_work = false;
    do_analysis_work = false;
    analysis_cv.notify_one();  // Despertar AnalysisWorker si está esperando

    // Esperar a que terminen los hilos de forma ordenada
    if (serial_thread.joinable())
        serial_thread.join();
    if (analysis_thread.joinable())
        analysis_thread.join();
    
    // Cerrar puerto serial
    serial.close();
    
    // IMPORTANTE: Limpiar datos congelados para que reconexión empiece limpio
    if (frozen) {
        frozen = false;
        frozen_dataX.clear();
        frozen_dataY.clear();
        frozen_dataY_filtered.clear();
        frozen_size = 0;
    }
}

void MainWindow::SelectFilter(Filter filter) {
    selected_filter = filter;
    
    // Calcular frecuencia de Nyquist (máxima frecuencia teórica = fs/2)
    int nyquist = settings->sampling_rate / 2;
    
    // Ajustar rango de frecuencia de corte según el tipo de filtro
    // IMPORTANTE: El rango máximo debe ser menor que Nyquist para evitar excepciones
    switch (selected_filter)
    {
        case Filter::LowPass:
            min_cutoff_frequency = 1;
            // Limitar a 2000 Hz o Nyquist-10 Hz (lo que sea menor)
            // Usar (std::min) con paréntesis para evitar conflicto con macro min() de Windows
            max_cutoff_frequency = (std::min)(2000, nyquist - 10);
            break;
        case Filter::HighPass:
            min_cutoff_frequency = 1;
            // Limitar a 2000 Hz o Nyquist-10 Hz (lo que sea menor)
            // Usar (std::min) con paréntesis para evitar conflicto con macro min() de Windows
            max_cutoff_frequency = (std::min)(2000, nyquist - 10);
            break;
        case Filter::None:
            break;
    }
    
    // VALIDACIÓN: Asegurar que la frecuencia de corte actual esté dentro del rango válido
    if (selected_filter != Filter::None) {
        int filter_idx = (int)selected_filter;
        if (cutoff_frequency[filter_idx] > max_cutoff_frequency) {
            cutoff_frequency[filter_idx] = max_cutoff_frequency;
        }
        if (cutoff_frequency[filter_idx] < min_cutoff_frequency) {
            cutoff_frequency[filter_idx] = min_cutoff_frequency;
        }
    }
}

void MainWindow::SetupFilter() {
    // Calcular frecuencia de Nyquist
    int nyquist = settings->sampling_rate / 2;
    
    switch (selected_filter)
    {
        case Filter::LowPass:
            // VALIDACIÓN: Asegurar que la frecuencia de corte sea válida
            if (cutoff_frequency[1] >= nyquist) {
                cutoff_frequency[1] = nyquist - 10;  // Seguridad: dejar margen de 10 Hz
            }
            if (cutoff_frequency[1] < 1) {
                cutoff_frequency[1] = 1;
            }
            lowpass_filter.setup(settings->sampling_rate, cutoff_frequency[1]);
            break;
            
        case Filter::HighPass:
            // VALIDACIÓN: Asegurar que la frecuencia de corte sea válida
            if (cutoff_frequency[2] >= nyquist) {
                cutoff_frequency[2] = nyquist - 10;  // Seguridad: dejar margen de 10 Hz
            }
            if (cutoff_frequency[2] < 1) {
                cutoff_frequency[2] = 1;
            }
            highpass_filter.setup(settings->sampling_rate, cutoff_frequency[2]);
            break;
            
        case Filter::None:
            break;
    }
}

void MainWindow::ResetFilters() {
    lowpass_filter.reset();
    highpass_filter.reset();
}

// ════════════════════════════════════════════════════════════════════════════════════════
// WORKER THREAD - Adquisición y Filtrado en Tiempo Real
// ════════════════════════════════════════════════════════════════════════════════════════
//
// PROPÓSITO:
// Hilo dedicado que maneja toda la comunicación serial bidireccional y aplicación de filtros.
// Se ejecuta en paralelo al hilo de UI sin bloquear la interfaz.
//
// PIPELINE DE PROCESAMIENTO:
// 1. Arduino → Serial → Leer buffer (128 bytes/bloque)
// 2. Transformar ADC (0-255) → Voltaje real (-6V a +6V)
// 3. Almacenar señal original en scrollY
// 4. Aplicar filtro digital seleccionado (IIR orden 8)
// 5. Almacenar señal filtrada en filter_scrollY
// 6. Transformar Voltaje → DAC (0-255)
// 7. Serial → Arduino → DAC PWM
//
// ARQUITECTURA THREAD-SAFE:
// - data_mutex protege escritura en buffers durante freeze/unfreeze
// - Lectura por bloques (128 bytes) reduce overhead vs byte a byte
// - Procesamiento en lote mejora caché locality
//
// LATENCIA TOTAL:
// - Lectura serial: ~260 μs por byte
// - Transformación ADC→V: ~5 ns
// - Filtro IIR: ~15 μs por muestra
// - Transformación V→DAC: ~5 ns
// - Escritura serial: ~260 μs por byte
// Total: ~1.04 ms (4 muestras @ 3840 Hz)
//
// RENDIMIENTO:
// Para fs = 3840 Hz:
// - 3840 muestras/segundo
// - 128 bytes/bloque → ~30 bloques/segundo
// - CPU usage: <2%
// ════════════════════════════════════════════════════════════════════════════════════════

void MainWindow::SerialWorker() {
    while (do_serial_work) {
        // Leer en bloques grandes para reducir overhead de syscalls
        int read = serial.read(read_buffer.data(), 128);

        if (read > 0) {
            // Proteger buffers contra acceso concurrente (freeze/unfreeze)
            std::lock_guard<std::mutex> lock(data_mutex);
            
            // Procesar bloque completo
            for (size_t i = 0; i < read; i++)
            {
                // Paso 1: Transformar ADC (0-255) → Voltaje (-6V a +6V)
                double transformado = TransformSample(read_buffer[i]);

                // Paso 2: Almacenar señal original
                scrollY->push(transformado);
                scrollX->push(next_time);

                double resultado = transformado;

                // Paso 3: Aplicar filtro digital IIR Butterworth orden 8
                switch (selected_filter)
                {
                    case Filter::LowPass:
                        resultado = lowpass_filter.filter(transformado);
                        break;
                    case Filter::HighPass:
                        resultado = highpass_filter.filter(transformado);
                        break;
                    case Filter::None:
                        break;  // Bypass: salida = entrada
                }

                // Paso 4: Almacenar señal filtrada
                filter_scrollY->push(resultado);
                next_time += 1.0 / settings->sampling_rate;

                // Paso 5: Transformar Voltaje → DAC para enviar de vuelta
                write_buffer[i] = InverseTransformSample(resultado);
            }

            size = scrollX->count();
            
            // Paso 6: Enviar bloque procesado de vuelta por serial
            serial.write(write_buffer.data(), read);
        }
    }
}

void MainWindow::AnalysisWorker() {
    while (do_analysis_work) {
        std::unique_lock lock(analysis_mutex);
        // Esperar notificación desde Draw() - solo se notifica en modo en vivo
        analysis_cv.wait(lock);

        if (!fft || !scrollY)
            continue;

        // Tomar hasta 1 segundo de muestras para el análisis FFT
        uint32_t available = scrollY->count();
        uint32_t max = settings->sampling_rate;
        uint32_t count = available > max ? max : available;

        auto end = scrollY->data() + available;
        fft->SetData(end - count, count);
        fft->Compute();

        std::this_thread::sleep_for(100ms);
    }
}

void MainWindow::Draw()
{
    static double elapsed_time = 0;

    // Actualizar tiempo transcurrido y límites de zoom automático solo en modo en vivo
    // VALIDACIÓN CRÍTICA: Verificar que scrollX existe y tiene datos ANTES de acceder
    if (started && !frozen) {
        std::lock_guard<std::mutex> lock(data_mutex);
        if (scrollX && scrollX->count() > 0) {
            elapsed_time = scrollX->back();

            // Auto-scroll: mantener ventana visible de max_time_visible segundos
            if (elapsed_time > max_time_visible) {
                right_limit = elapsed_time;
                left_limit = elapsed_time - max_time_visible;
            }
            else {
                // Al inicio, cuando aún no hay suficientes datos
                left_limit = 0;
                right_limit = max_time_visible;
            }
        }
    }

    // IMPORTANTE: Forzar que el rango visible SIEMPRE sea exactamente max_time_visible
    // Esto asegura que las divisiones ocupen todo el ancho del gráfico
    if (!frozen) {
        right_limit = left_limit + max_time_visible;
    }
    else {
        frozen_right_limit = frozen_left_limit + max_time_visible;
    }

    // Seleccionar fuente de datos según el estado (congelado vs en vivo)
    const double* dataX = nullptr;
    const double* dataY = nullptr;
    const double* dataY_filtered = nullptr;
    int current_draw_size = 0;
    
    if (frozen && !frozen_dataX.empty()) {
        // Modo congelado: usar snapshot guardado (no se actualiza hasta reanudar)
        dataX = frozen_dataX.data();
        dataY = frozen_dataY.data();
        dataY_filtered = frozen_dataY_filtered.data();
        current_draw_size = frozen_size / settings->stride;
    }
    else if (!frozen && scrollX && scrollY && filter_scrollY) {
        // Modo en vivo: usar buffers circulares actuales (actualizados por SerialWorker)
        // VALIDACIÓN CRÍTICA: Proteger acceso con mutex y verificar existencia
        std::lock_guard<std::mutex> lock(data_mutex);
        
        // IMPORTANTE: Solo usar buffers si TODOS existen y tienen tamaño válido
        if (scrollX && scrollY && filter_scrollY && size > 0) {
            dataX = scrollX->data();
            dataY = scrollY->data();
            dataY_filtered = filter_scrollY->data();
            current_draw_size = size / settings->stride;
        }
        else {
            // Buffers no listos: forzar current_draw_size = 0 para que ImPlot no dibuje
            current_draw_size = 0;
        }
    }
    else {
        // Estado inválido: ningún dato disponible
        current_draw_size = 0;
    }

    // Dibujar panel lateral con controles
    DrawSidebar();

    // Ventana principal: área de gráficos a la derecha del sidebar
    ImGui::SetNextWindowPos({ sidebar_width, 0 });
    ImGui::SetNextWindowSize(ImVec2(width - sidebar_width, height));
    ImGui::PushStyleVar(ImGuiStyleVar_WindowBorderSize, 0);
    ImGui::PushStyleVar(ImGuiStyleVar_WindowPadding, ImVec2(8, 8));
    ImGui::Begin("Ventana principal", &open,
                 ImGuiWindowFlags_NoResize | ImGuiWindowFlags_NoTitleBar |
                 ImGuiWindowFlags_NoBringToFrontOnFocus);  // QUITAMOS NoScrollbar para permitir scroll
    ImGui::PopStyleVar(2);

    auto win_pos = ImGui::GetWindowPos();
    auto win_size = ImGui::GetWindowSize();

    // Calcular altura para distribuir los 3 gráficos equitativamente
    float available_height = ImGui::GetContentRegionAvail().y;
    float header_height = 25.0f;  // Espacio para headers colapsables
    float graph_height = (available_height - header_height * 2) / 3.0f;

    // === SISTEMA DE DIVISIONES TIPO OSCILOSCOPIO ===
    // La escala temporal seleccionada define EXACTAMENTE cuánto tiempo muestra la pantalla completa
    // Ejemplo: "1 ms/div" seleccionado = la pantalla muestra EXACTAMENTE 16ms (1ms × 16 divisiones)
    
    // Número fijo de divisiones (16 como solicitado)
    const int num_divisions = 16;
    
    // Calcular límites de las divisiones basados en left_limit
    // Las divisiones SIEMPRE ocupan todo el ancho del gráfico
    double tick_start = frozen ? frozen_left_limit : left_limit;
    double tick_end = frozen ? frozen_right_limit : right_limit;
    
    // === GRÁFICO 1: ENTRADA (señal cruda) ===
    if (ImPlot::BeginPlot("Entrada", { -1, graph_height }, ImPlotFlags_NoLegend)) {
        // Configurar ejes según el estado de freeze
        if (frozen) {
            // Modo congelado: zoom manual independiente del modo en vivo
            ImPlot::SetupAxisLinks(ImAxis_X1, &frozen_left_limit, &frozen_right_limit);
            ImPlot::SetupAxisLinks(ImAxis_Y1, &frozen_down_limit, &frozen_up_limit);
            
            ImPlot::SetupAxisFormat(ImAxis_Y1, MetricFormatter, (void*)"V");
            ImPlot::SetupAxisFormat(ImAxis_X1, MetricFormatter, (void*)"s");

            ImPlot::SetupAxisLimits(ImAxis_Y1, frozen_down_limit, frozen_up_limit, ImGuiCond_Once);
            ImPlot::SetupAxisLimits(ImAxis_X1, frozen_left_limit, frozen_right_limit, ImGuiCond_Always);
        }
        else {
            // Modo en vivo: zoom sincronizado con gráfico de Salida
            ImPlot::SetupAxisLinks(ImAxis_X1, &left_limit, &right_limit);
            ImPlot::SetupAxisLinks(ImAxis_Y1, &down_limit, &up_limit);
            
            ImPlot::SetupAxisFormat(ImAxis_Y1, MetricFormatter, (void*)"V");
            ImPlot::SetupAxisFormat(ImAxis_X1, MetricFormatter, (void*)"s");

            ImPlot::SetupAxisLimits(ImAxis_Y1, -7, 7, ImGuiCond_FirstUseEver);
            ImPlot::SetupAxisLimits(ImAxis_X1, left_limit, right_limit, ImGuiCond_Always);
        }
        
        // Configurar divisiones del eje X: 16 divisiones que ocupan TODO el ancho
        ImPlot::SetupAxisTicks(ImAxis_X1, tick_start, tick_end, num_divisions + 1);
        ImPlot::SetupAxisLimitsConstraints(ImAxis_X1, 0, INFINITY);

        // Dibujar línea con color verde #1CC809
        if (dataX && dataY && current_draw_size > 0) {
            ImPlot::PushStyleColor(ImPlotCol_Line, ImVec4(0.110f, 0.784f, 0.035f, 1.0f));
            ImPlot::PlotLine("", dataX, dataY, current_draw_size, 0, 0, settings->byte_stride);
            ImPlot::PopStyleColor();
        }
        ImPlot::EndPlot();
    }

    // === SECCIÓN FILTRO (colapsable) ===
    filter_open = ImGui::CollapsingHeader("Filtro", ImGuiTreeNodeFlags_DefaultOpen);
    if (filter_open) {
        // === GRÁFICO 2: SALIDA (señal filtrada) ===
        if (ImPlot::BeginPlot("Salida", { -1, graph_height }, ImPlotFlags_NoLegend)) {
            // Configurar ejes según el estado de freeze
            if (frozen) {
                // Modo congelado: zoom manual independiente
                ImPlot::SetupAxisLinks(ImAxis_X1, &frozen_left_limit, &frozen_right_limit);
                ImPlot::SetupAxisLinks(ImAxis_Y1, &frozen_down_limit, &frozen_up_limit);
                
                ImPlot::SetupAxisFormat(ImAxis_Y1, MetricFormatter, (void*)"V");
                ImPlot::SetupAxisFormat(ImAxis_X1, MetricFormatter, (void*)"s");

                ImPlot::SetupAxisLimits(ImAxis_Y1, frozen_down_limit, frozen_up_limit, ImGuiCond_Once);
                ImPlot::SetupAxisLimits(ImAxis_X1, frozen_left_limit, frozen_right_limit, ImGuiCond_Always);
            }
            else {
                // Modo en vivo: zoom sincronizado con gráfico de Entrada
                ImPlot::SetupAxisLinks(ImAxis_X1, &left_limit, &right_limit);
                ImPlot::SetupAxisLinks(ImAxis_Y1, &down_limit, &up_limit);
                
                ImPlot::SetupAxisFormat(ImAxis_Y1, MetricFormatter, (void*)"V");
                ImPlot::SetupAxisFormat(ImAxis_X1, MetricFormatter, (void*)"s");

                ImPlot::SetupAxisLimits(ImAxis_Y1, -7, 7, ImGuiCond_FirstUseEver);
                ImPlot::SetupAxisLimits(ImAxis_X1, left_limit, right_limit, ImGuiCond_Always);
            }
            
            // Usar las mismas divisiones que el gráfico de Entrada
            ImPlot::SetupAxisTicks(ImAxis_X1, tick_start, tick_end, num_divisions + 1);
            ImPlot::SetupAxisLimitsConstraints(ImAxis_X1, 0, INFINITY);

            // Dibujar línea filtrada con color verde #1CC809
            if (dataX && dataY_filtered && current_draw_size > 0) {
                ImPlot::PushStyleColor(ImPlotCol_Line, ImVec4(0.110f, 0.784f, 0.035f, 1.0f));
                ImPlot::PlotLine("", dataX, dataY_filtered, current_draw_size, 0, 0, settings->byte_stride);
                ImPlot::PopStyleColor();
            }
            ImPlot::EndPlot();
        }

        // Botones de selección de filtro
        const char* nombres[] = { "Ninguno", "Pasa bajos", "Pasa altos" };
        for (int i = 0; i < std::size(nombres); i++)
        {
            if (i > 0)
                ImGui::SameLine();

            if (i == (int)selected_filter) {
                ImGui::PushStyleColor(ImGuiCol_Button, ImGui::GetStyle().Colors[ImGuiCol_ButtonActive]);
                ImGui::Button(nombres[i]);
                ImGui::PopStyleColor();
            }
            else {
                if (ImGui::Button(nombres[i])) {
                    SelectFilter((Filter)i);
                    ResetFilters();
                }
            }
        }

        // Control de frecuencia de corte (solo visible si hay filtro activo)
        if (selected_filter != Filter::None
            && ImGui::SliderInt("Frecuencia de corte", &cutoff_frequency[(int)selected_filter], min_cutoff_frequency, max_cutoff_frequency)) {
            SetupFilter();
            ResetFilters();
        }
    }

    // === SECCIÓN ANÁLISIS (colapsable) ===
    if (ImGui::CollapsingHeader("Análisis", ImGuiTreeNodeFlags_DefaultOpen)) {
        // Notificar al worker de análisis FFT (solo en modo en vivo)
        if (!frozen) {
            analysis_cv.notify_one();
        }
        
        // === GRÁFICO 3: ESPECTRO (FFT) ===
        if (ImPlot::BeginPlot("Espectro", { -1, graph_height }, ImPlotFlags_NoLegend)) {
            ImPlot::SetupAxisFormat(ImAxis_Y1, MetricFormatter, (void*)"V");
            ImPlot::SetupAxisFormat(ImAxis_X1, MetricFormatter, (void*)"Hz");
            
            // Configurar escala del eje X según selección del usuario
            if (spectrum_log_scale) {
                ImPlot::SetupAxisScale(ImAxis_X1, ImPlotScale_Log10);
                ImPlot::SetupAxisLimits(ImAxis_X1, 0.99, settings->samples, ImGuiCond_FirstUseEver);
            } else {
                ImPlot::SetupAxisScale(ImAxis_X1, ImPlotScale_Linear);
                // En escala lineal, mostrar desde 0 Hz hasta Nyquist (fs/2)
                double nyquist_freq = settings->sampling_rate / 2.0;
                ImPlot::SetupAxisLimits(ImAxis_X1, 0, nyquist_freq, ImGuiCond_FirstUseEver);
            }
            
            ImPlot::SetupAxis(ImAxis_Y1, nullptr, ImPlotAxisFlags_AutoFit);
            ImPlot::SetupAxisLimitsConstraints(ImAxis_Y1, 0, INFINITY);

            // Dibujar el espectro FFT
            // VALIDACIÓN CRÍTICA: Solo dibujar si FFT existe
            if (fft) {
                fft->Plot(settings->sampling_rate);
            }
            
            // Marcador visual de la frecuencia dominante (línea vertical roja)
            // VALIDACIÓN CRÍTICA: Verificar FFT antes de acceder
            if (fft && show_dominant_frequency_marker && scrollY && scrollY->count() > 0) {
                double dominant_freq = fft->Frequency(settings->sampling_rate);
                if (dominant_freq > 0) {
                    // Obtener los límites actuales del gráfico para la altura de la línea
                    ImPlotRect limits = ImPlot::GetPlotLimits();
                    double line_x[2] = { dominant_freq, dominant_freq };
                    double line_y[2] = { limits.Y.Min, limits.Y.Max };
                    
                    ImPlot::PushStyleColor(ImPlotCol_Line, ImVec4(0.9f, 0.1f, 0.1f, 0.8f)); // Rojo semi-transparente
                    ImPlot::PushStyleVar(ImPlotStyleVar_LineWeight, 2.0f); // Línea más gruesa
                    ImPlot::PlotLine("Freq. Dominante", line_x, line_y, 2);
                    ImPlot::PopStyleVar();
                    ImPlot::PopStyleColor();
                }
            }
            
            ImPlot::EndPlot();
        }
        
        // === CONTROLES DEL ESPECTRO ===
        // Botones para alternar escala del eje X
        ImGui::Spacing();
        ImGui::Text("Escala del eje X:");
        ImGui::SameLine();
        
        if (spectrum_log_scale) {
            ImGui::PushStyleColor(ImGuiCol_Button, ImGui::GetStyle().Colors[ImGuiCol_ButtonActive]);
            ImGui::Button("Logarítmica");
            ImGui::PopStyleColor();
        } else {
            if (ImGui::Button("Logarítmica")) {
                spectrum_log_scale = true;
            }
        }
        
        ImGui::SameLine();
        
        if (!spectrum_log_scale) {
            ImGui::PushStyleColor(ImGuiCol_Button, ImGui::GetStyle().Colors[ImGuiCol_ButtonActive]);
            ImGui::Button("Lineal");
            ImGui::PopStyleColor();
        } else {
            if (ImGui::Button("Lineal")) {
                spectrum_log_scale = false;
            }
        }
        
        // Checkbox para mostrar/ocultar marcador de frecuencia dominante
        ImGui::SameLine();
        ImGui::Checkbox("Mostrar freq. dominante", &show_dominant_frequency_marker);

            // === INFORMACIÓN DE ANÁLISIS ESPECTRAL ===
            // VALIDACIÓN CRÍTICA: Verificar que FFT y buffers existen antes de acceder
            if (fft && scrollY && scrollY->count() > 0) {
                ImGui::Spacing();
                ImGui::Separator();
                
                // Mostrar información de frecuencia dominante de forma prominente
                double dominant_freq = fft->Frequency(settings->sampling_rate);
                double dc_offset = fft->Offset();
                
                // Texto con formato destacado para frecuencia dominante
                ImGui::Text("FRECUENCIA DOMINANTE (FUNDAMENTAL):");
                ImGui::SameLine();
                ImGui::TextColored(ImVec4(0.9f, 0.1f, 0.1f, 1.0f), "%s", 
                                  MetricFormatter(dominant_freq, "Hz").data());
                
                // Información adicional en misma línea
                ImGui::SameLine();
                ImGui::Text("|");
                ImGui::SameLine();
                ImGui::Text("Offset DC: %s", MetricFormatter(dc_offset, "V").data());
                
                ImGui::Spacing();
                ImGui::Separator();
                ImGui::Text("ARMÓNICAS DETECTADAS:");
                ImGui::Spacing();
                
                // Detectar las 10 primeras armónicas
                auto harmonics = fft->FindHarmonics(settings->sampling_rate, 10);
                
                // Mostrar tabla con formato estructurado
                if (!harmonics.empty()) {
                    // NOTA: Mostrar advertencia si solo hay 1 armónica
                    if (harmonics.size() == 1) {
                        double fundamental = harmonics[0].frequency;
                        double nyquist = settings->sampling_rate / 2.0;
                        
                        ImGui::TextColored(ImVec4(0.9f, 0.6f, 0.0f, 1.0f), 
                            "ADVERTENCIA: Solo se detecta la fundamental (%.0f Hz)", fundamental);
                        ImGui::Text("La 2da armonica (%.0f Hz) excede Nyquist (%.0f Hz)", 
                            fundamental * 2, nyquist);
                        ImGui::Text("Solucion: Aumenta la frecuencia de muestreo para detectar armonicas");
                        ImGui::Spacing();
                        ImGui::Separator();
                    }
                    
                    // Crear región scrollable para la tabla de armónicas (altura fija de 200 píxeles)
                    ImGui::BeginChild("HarmonicsTable", ImVec2(0, 200), true, ImGuiWindowFlags_HorizontalScrollbar);
                    
                    // Configurar tabla de 3 columnas
                    ImGui::Columns(3, "harmonics_table");
                    ImGui::Separator();
                    
                    // Encabezados de tabla
                    ImGui::Text("Armónica"); ImGui::NextColumn();
                    ImGui::Text("Frecuencia"); ImGui::NextColumn();
                    ImGui::Text("Amplitud"); ImGui::NextColumn();
                    ImGui::Separator();
                    
                    // Datos de cada armónica detectada
                    for (size_t i = 0; i < harmonics.size(); i++) {
                        // Columna 1: Número de armónica (1ª, 2ª, 3ª, etc.)
                        ImGui::Text("%dª", static_cast<int>(i + 1)); 
                        ImGui::NextColumn();
                        
                        // Columna 2: Frecuencia en Hz con formato métrico
                        ImGui::Text("%s", 
                                   MetricFormatter(harmonics[i].frequency, "Hz").data());
                        ImGui::NextColumn();
                        
                        // Columna 3: Amplitud en Voltios con formato métrico
                        ImGui::Text("%s", 
                                   MetricFormatter(harmonics[i].amplitude, "V").data());
                        ImGui::NextColumn();
                    }
                    
                    // Volver a 1 columna
                    ImGui::Columns(1);
                    
                    ImGui::EndChild();  // Fin de la región scrollable
                    
                    ImGui::Separator();
                    
                    // OPCIONAL: Calcular y mostrar THD (Total Harmonic Distortion)
                    if (harmonics.size() >= 3) {
                        double fundamental = harmonics[0].amplitude;
                        double thd_sum = 0;
                        
                        // THD = sqrt(A₂² + A₃² + ...) / A₁
                        for (size_t i = 1; i < harmonics.size(); i++) {
                            thd_sum += harmonics[i].amplitude * harmonics[i].amplitude;
                        }
                        
                        double thd = (fundamental > 0) ? 
                                     (std::sqrt(thd_sum) / fundamental * 100.0) : 0;
                        
                        ImGui::Text("Distorsión Armónica Total (THD): %.2f%%", thd);
                    }
                } else {
                    // Mensaje cuando no hay datos suficientes
                    ImGui::TextColored(ImVec4(0.7f, 0.7f, 0.7f, 1.0f), 
                                      "  No hay datos suficientes para análisis");
                }
            }
    }

    ImGui::End();
}

void MainWindow::SetSize(int width, int height) {
    this->width = width;
    this->height = height;
}
