LJKuhn/dsp-arduino-serialplotter/SerialPlotter/src/FFT.h

//



//


// - Calcula solo las frecuencias positivas (transformada real a compleja)

// - Calcula el offset DC (componente de frecuencia 0)


#pragma once

#include <fftw3.h>
#include <vector>

// Estructura para almacenar información de armónicas detectadas
struct Harmonic {
	double frequency;   // Frecuencia en Hz
	double amplitude;   // Amplitud en Voltios
	int bin_index;      // Índice del bin en el espectro FFT
};

class FFT {
	fftw_complex* complex;
	fftw_plan p;

	int samples_size;
	int amplitudes_size;
	std::vector<double> samples;     // Buffer de entrada (dominio del tiempo)
	std::vector<double> amplitudes;  // Buffer de salida (magnitudes de frecuencias)

	double offset = 0;        // Offset DC (componente de frecuencia 0)
	int n_frequency = 0;
	std::vector<Harmonic> detected_harmonics;  // Almacena las armónicas detectadas
public:
	// Constructor

	explicit FFT(int sample_count);
	
	~FFT();

	// Dibuja el espectro de frecuencias usando ImPlot
	// sampling_frequency: frecuencia de muestreo en Hz (determina el rango de frecuencias)
	void Plot(double sampling_frequency);


	// data: puntero a array de muestras en dominio del tiempo
	// count: cantidad de muestras (si es menor que sample_count, se rellena con ceros)
	void SetData(const double* data, uint32_t count);

	// Ejecuta la FFT y calcula las amplitudes de frecuencia

	void Compute();


	double Offset() const;
	
	// Retorna la frecuencia dominante en Hz

	double Frequency(double sampling_frequency) const;	
	// Acceso al espectro completo de amplitudes
	const std::vector<double>& GetAmplitudes() const { return amplitudes; }
	int GetAmplitudesSize() const { return amplitudes_size; }
	
	// Detección de armónicas (múltiplos de la frecuencia fundamental)
	// sampling_frequency: frecuencia de muestreo en Hz
	// count: número de armónicas a detectar (por defecto 3)
	// Retorna: vector con información de cada armónica detectada
	std::vector<Harmonic> FindHarmonics(double sampling_frequency, int count = 3);
	
	// Obtener amplitud de un bin específico del espectro
	double GetAmplitudeAt(int bin) const;};
