LJKuhn/dsp-arduino-serialplotter/SerialPlotter/src/Settings.cpp

// Settings.cpp - Implementación de ventana de configuración y widgets auxiliares
//
// NOTA IMPORTANTE: Esta ventana de configuración está DEPRECATED.
// Todas las opciones ahora están integradas directamente en el sidebar
// de MainWindow para mejor accesibilidad y flujo de trabajo.

#include <imgui.h>

#include "Serial.h"
#include "Settings.h"

using namespace std::string_literals;

// Arrays de opciones disponibles
const int bauds[] = { 1200, 2400, 4800, 9600, 14400, 19200, 38400, 57600, 115200, 230400, 250000, 460800, 500000, 921600, 1000000, 2000000 };

// Frecuencias de muestreo disponibles (Hz) - optimizadas para Arduino Mega
// El Mega puede manejar frecuencias más altas gracias a sus 4 UARTs y más RAM
const int frecuencias[] = { 120, 240, 480, 960, 1440, 1920, 3840, 5760, 7680, 11520, 15360, 23040, 25000, 46080, 50000, 92160, 100000 };

#include "Widgets.h"

// Widget combo para seleccionar frecuencia de muestreo
void ComboFrecuenciaMuestreo(int& selected) {
    std::function to_string = [](int n) { return std::to_string(n); };

    combo("Frecuencia", selected, frecuencias, to_string);
}

// Widget combo para seleccionar velocidad de comunicación serial
void ComboBaudRate(int& selected) {
    std::function to_string = [](int n) { return std::to_string(n); };

    combo("Velocidad", selected, bauds, to_string);
}

// Widget combo para seleccionar puerto COM
void ComboPuertos(std::string& selected_port) {
    auto puertos = EnumerateComPorts();
    std::function to_string = [](std::string s) { return s; };

    combo("Puerto", selected_port, puertos, to_string, "No hay ningún dispositivo conectado");
}

SettingsWindow::SettingsWindow(Settings& settings) : settings(settings), open(settings.open)
{
}

void SettingsWindow::Toggle() {
    open = !open;
}

// DEPRECATED: Esta ventana ya no se utiliza activamente.
// Todas las opciones de configuración ahora están integradas
// directamente en el sidebar de MainWindow para acceso rápido.
// Se mantiene este código por compatibilidad pero no se dibuja.
void SettingsWindow::Draw() {
    using namespace ImGui;
    static int stride_exp = 2;

    if (!open)
        return;

    Begin("Configuración", &open);

    // Selector de frecuencia de muestreo
    ComboFrecuenciaMuestreo(settings.sampling_rate);
    
    // Selector de velocidad de comunicación
    ComboBaudRate(settings.baud_rate);
    
    // Selector de puerto COM
    ComboPuertos(settings.port);

    // Sincronizar cantidad de muestras con frecuencia de muestreo
    settings.samples = settings.sampling_rate;

    // Sección de mapeo ADC a voltaje (colapsable)
    if (TreeNode("Mapeo")) {
        SliderInt("Máximo", &settings.maximum, 0, 255);
        SliderInt("Mínimo", &settings.minimum, 0, 255);
        settings.map_factor = 12.0 / (settings.maximum - settings.minimum);
        TreePop();
    }

    // Sección de optimización de rendimiento (colapsable)
    if (TreeNode("Rendimiento")) {
        // Stride exponencial (2^n) para reducir puntos dibujados
        if (SliderInt("Stride", &stride_exp, 0, 10)) {
            settings.stride = (int)exp2(stride_exp);
            settings.byte_stride = sizeof(double) * settings.stride;
        }
        SetItemTooltip("Dibuja 1 de cada 2^n muestras para mejorar el rendimiento.");

        Checkbox("Mostrar tiempo de renderizado", &settings.show_frame_time);
        TreePop();
    }

    End();
}
