LJKuhn/dsp-arduino-serialplotter/(commit log)

2026-01-24 Initial commit: DSP Arduino SerialPlotter project
2026-01-26 agregado boton de freeze y modificacion del funcionamiento del zoom
2026-01-27 cambio de colores y de funcionamiento
2026-01-27 correccion de crasheo en el boton de freeze y se modifico la estructura de la barra lateral
    [MainWindow.cpp, MainWindow.h, Settings.cpp, Settings.h, main.cpp]
2026-02-04 actualizacion de documentacion
2026-02-05 agregado documentos de trabajos practicos
2026-02-05 documentacion detallada de estructura de carpetas y limpieza de archivos innecesarios
2026-02-12 actualización de disposición de códigos, creación de sub versiones y cambios en la documentación e informe
2026-02-24 Reorganización del proyecto y limpieza de documentación
2026-02-26 Nuevos selectores de escala y optimizacion de guradado de la señal en buffers de memoria
2026-02-27 correccion de velocidades de comunicacion, buffers en el arduino y ejecucion del cambio del puerto A arduino
2026-02-27 creacion de variantes para pruebas
2026-04-10 Actualizacion de informe y documentos teóricos
2026-04-23 actualizacion de documentacion y de bugs
    [FFT.cpp, FFT.h, MainWindow.cpp, adc.cpp, adc.h, prescaler.h, tablas.h, timer1.h]
2026-05-04 Actualizacion informe antes de mandar
2026-05-04 Agregar DSP_Overclock: versión 7680 Hz @ 115200 bps (2x velocidad)
2026-05-04 Optimización memoria RAM y mejoras DSP
    - Arduino_Uno_Auto_Waveforms: Reducido de 13 a 9 señales (104% → ~70% RAM)
    * Mantenidas: 5 senoidales (500-2500Hz) + 4 cuadradas (900-2500Hz)
    * Triangulares comentadas para ahorrar RAM (fácil restauración)
    * Ciclo optimizado: 135s (9×15s) vs 195s anterior
    - DSP_Overclock: Solucionados errores de compilación
    * Copiados archivos localmente (adc.h/cpp, timer1.h, tablas.h, prescaler.h)
    * Eliminadas declaraciones duplicadas de objetos globales
    * Corregidas referencias timer1 → timer
    - SerialPlotter: Mejoras visualización espectros
    * Escala configurable (lineal/logarítmica) para eje X
    * Marcador visual frecuencia dominante (líne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
    [MainWindow.cpp, adc.cpp, adc.h, prescaler.h, tablas.h, timer1.h]
2026-05-05 Modificaciones de informe: correcciones de contenido y fórmulas
2026-05-07 obtencion de capturas de la interface
2026-05-13 README: reescritura profesional para publicacion
2026-05-13 Corregir rutas, mejorar presentabilidad para LinkedIn y actualizar .gitignore
2026-05-13 Reorganización de documentación y carpetas
